lambert/AJ/README.md

# AJ SX28AC/DP board with an Arduino UNO R3 form factor

[Documentation](docs/README.md).

[Electrical CAD files](ecad/README.md)

[Mechanical CAD files](mcad/README.md)

CC BY-SA
