lambert/AJ/ecad/gschem/README.md

# Schematic entry

## Schematics

[Front page](AJ.000.00.00.01.sch)

[Arduino Parallax/Scenix SX28AC Board - schematic](AJ.001.00.01.01.sch)

[Oscillator Daughter Board - schematic](AJ.002.00.01.01.sch)

Schematic entry requires [gschem version 1.6.2-20110115](http://wiki.geda-project.org/geda:download) or later.

## Engineering Change Orders

[ECO-001](ECO-001.md)

[ECO-002](ECO-002.md)

## Generated files

[Bill Of Materials](BOM/README.md)

[Design Rule Checking reports](DRC/README.ms)

[Netlist Checking reports](geda-netlist/README.md)
