lambert/AJ/ecad/pcb/plotfiles/README.md

# Plot files (PDF)

[AJ.001.00.01.01](AJ.001.00.01.01.pcb.pdf)
