lambert/AJ/ecad/pcb/eyecandy/README.md

# Eye candy

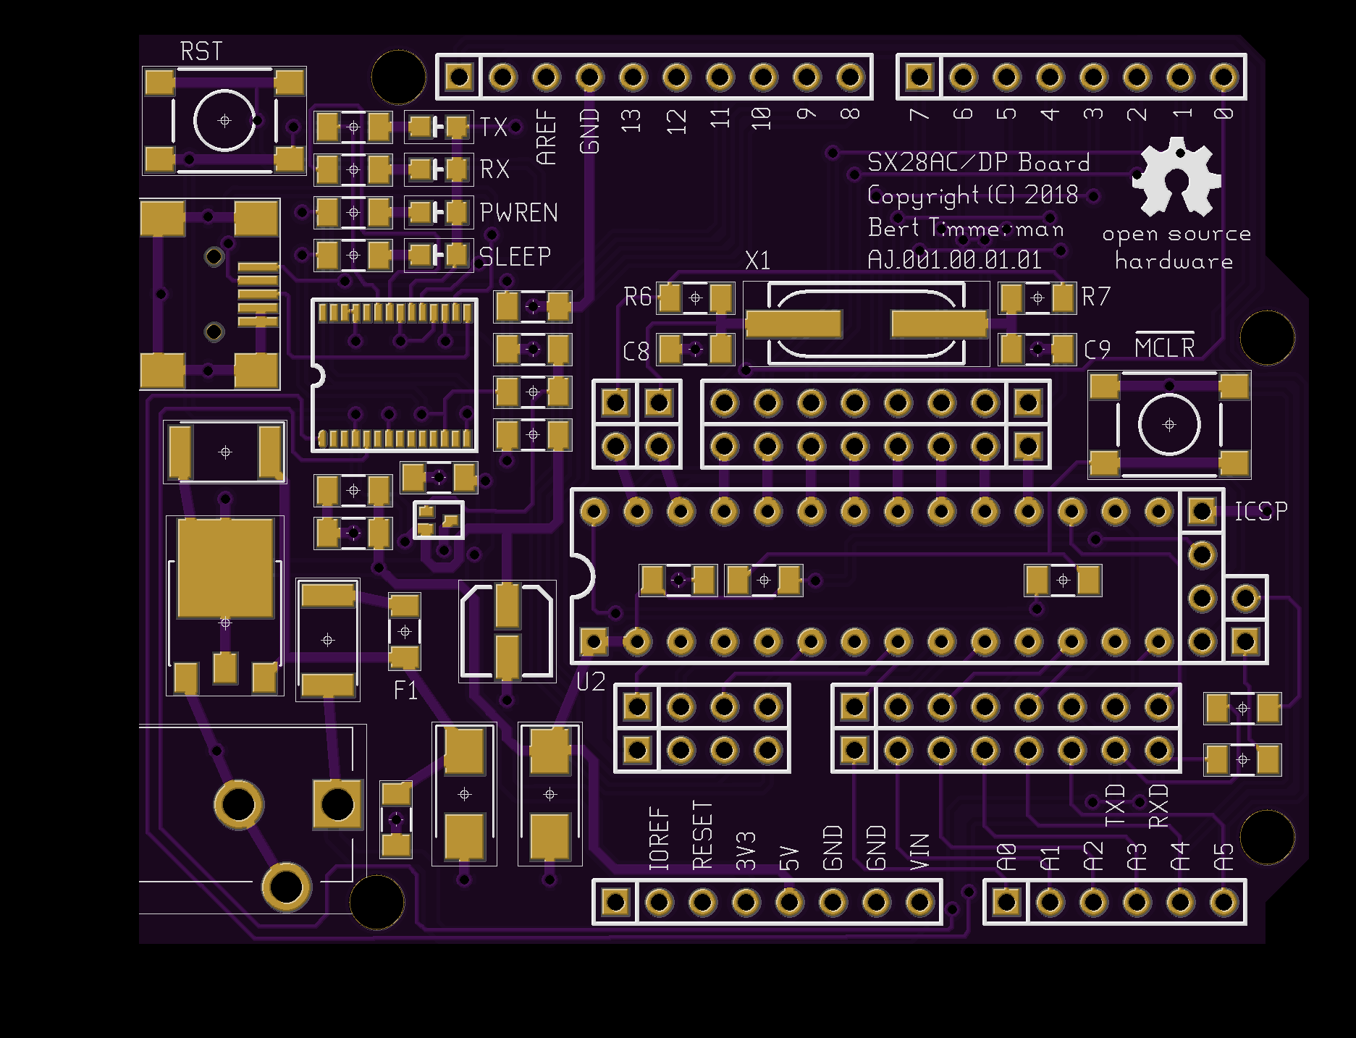
[picture p2: ecad/pcb/eyecandy/AJ.001.00.01.01.pcb.top.png]
Top view


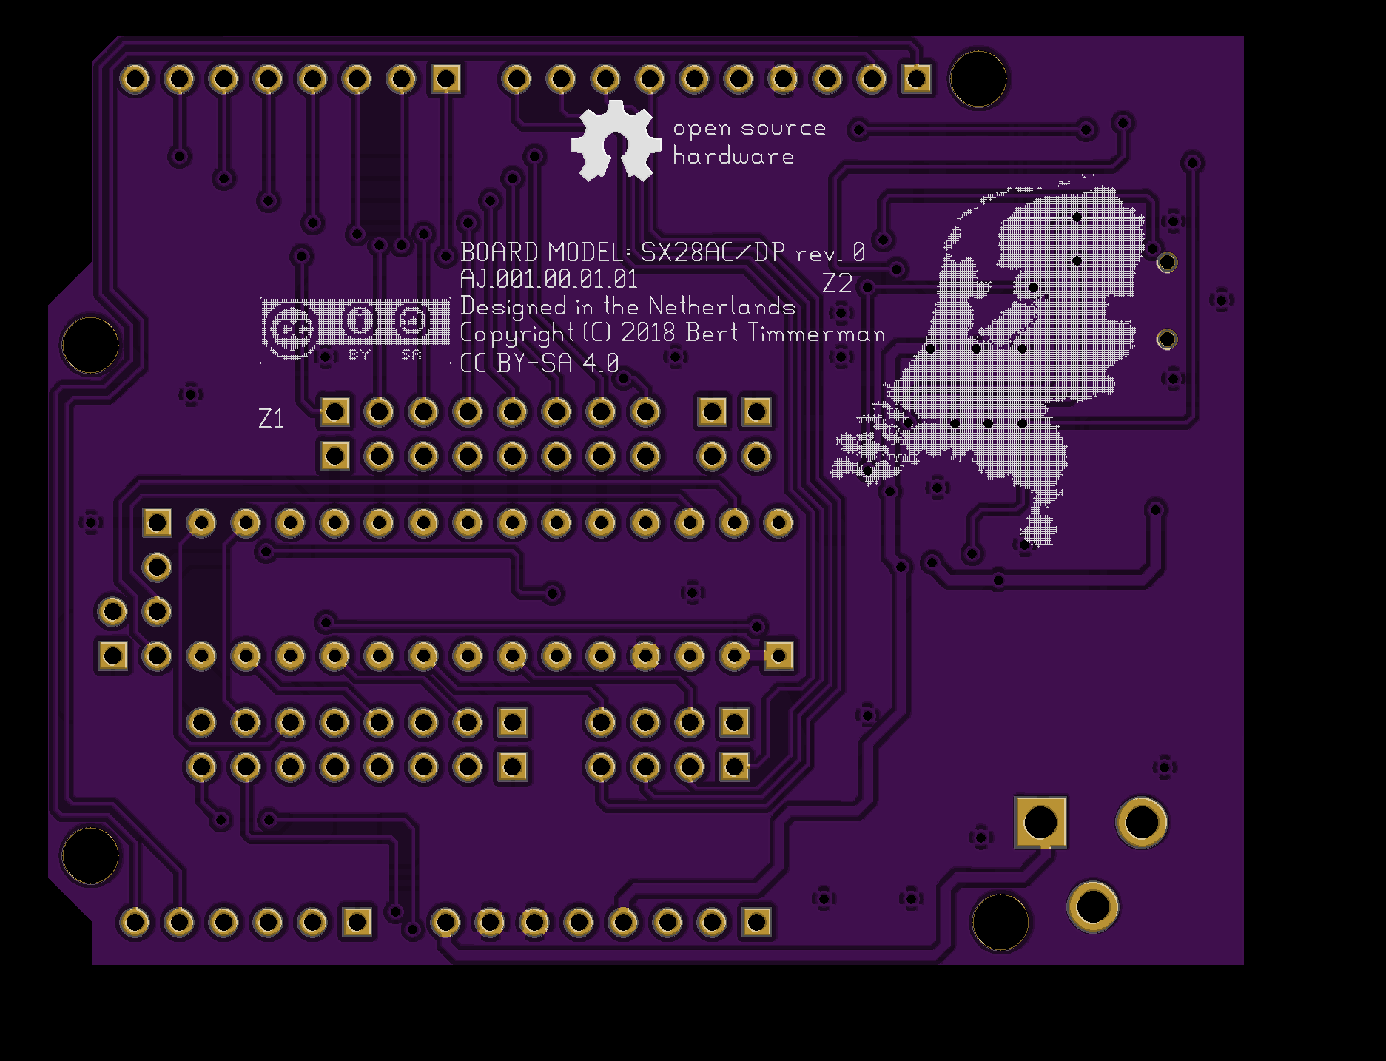
[picture p3: ecad/pcb/eyecandy/AJ.001.00.01.01.pcb.bottom.png]
Bottom view
