lambert/AJ/ecad/gschem/ECO-002.md

# Engineering Change Order 002

## Description:

New revisons need a power indicator LED for both USB (USB_5V) and jack power (5V).

A power indicator for 3V3 and/or Vcc if enough board space available.

## Remedial actions:

Add to schematic and BOM.

Redesign layout (revision 01).

Purchase additional parts.
