lambert/AJ/docs/purchase/SeeedStudio/README.md

# SeeedSudio Fusion PCB

[Fusion PCB specification](fusion_pcb_specification.md)

[PCB Order information](pcb_order_information.md)
