lambert/AJ/ecad/gschem/BOM/README.md

# Bill Of Materials

[Bill Of Materials](AJ_ARDUINO_SX28AC_Board_bom.csv)
