lambert/AJ/ecad/pcb/bom/README.md

# Bill Of Materials

[AJ.001.00.01.01 Main Board](AJ.001.00.01.01.pcb.bom)
