lambert/AJ/docs/purchase/SeeedStudio/pcb_order_information.md

# PCB Order information

Order Number : 180915202001

2018-09-15 14:15:01

Total : USD 12.50

Ship To : Bert Timmerman

Status : Confirmed

Fusion PCB

SKU: 501010001

USD 1.00 × 1

PCB Dimension - 100 mm * 100 mm

Impedance Control - No

Surface Finish - HASL

Min Solder Mask Dam - 0.4 mm

Copper Weight - 1 oz.

Half-cut / Castellated Holes - No

Min Hole Size - 0.3 mm

PCB Color - Green

Material - FR4 TG130

Layer - 2

PCB Qty. - 3

Blind Vias - No

PCB Thickness - 1.6 mm

Min Tracking / Spacing - 6/6 mil

Panelized PCBs - 1

Expedited Option - No

File - D_928359_aj00100.zip

# Received PCBs

[Photo 1](20181011_01.jpg)

[Photo 2](20181011_02.jpg)

[Photo 3](20181011_03.jpg)

[Photo 4](20181011_04.jpg)

[Photo 5](20181011_05.jpg)
