lambert/AJ/docs/purchase/OSH_Park/AJ-001-00/pics/AJ-001-00_bottom_silk_screen.png

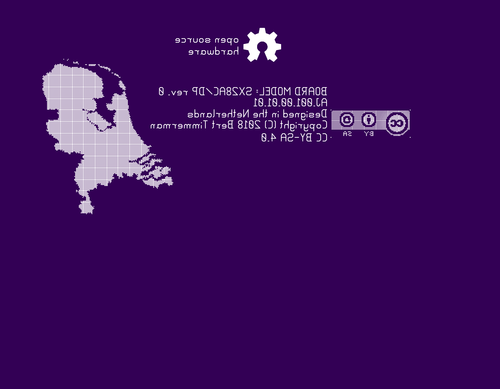
docs/purchase/OSH_Park/AJ-001-00/pics/AJ-001-00_bottom_silk_screen.png
