lambert/AJ/docs/purchase/SeeedStudio/20181011_01.jpg

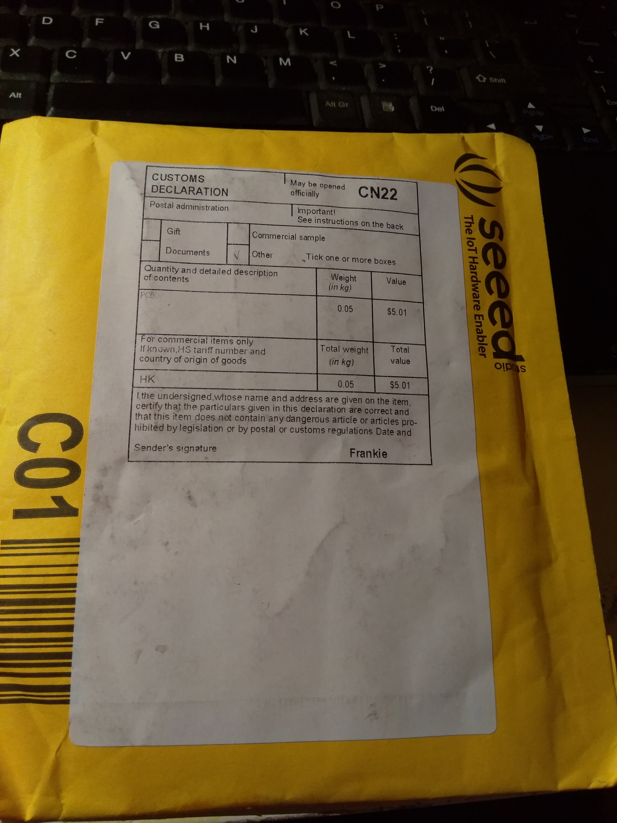
docs/purchase/SeeedStudio/20181011_01.jpg
