lambert/AJ/docs/purchase/SeeedStudio/20181011_02.jpg

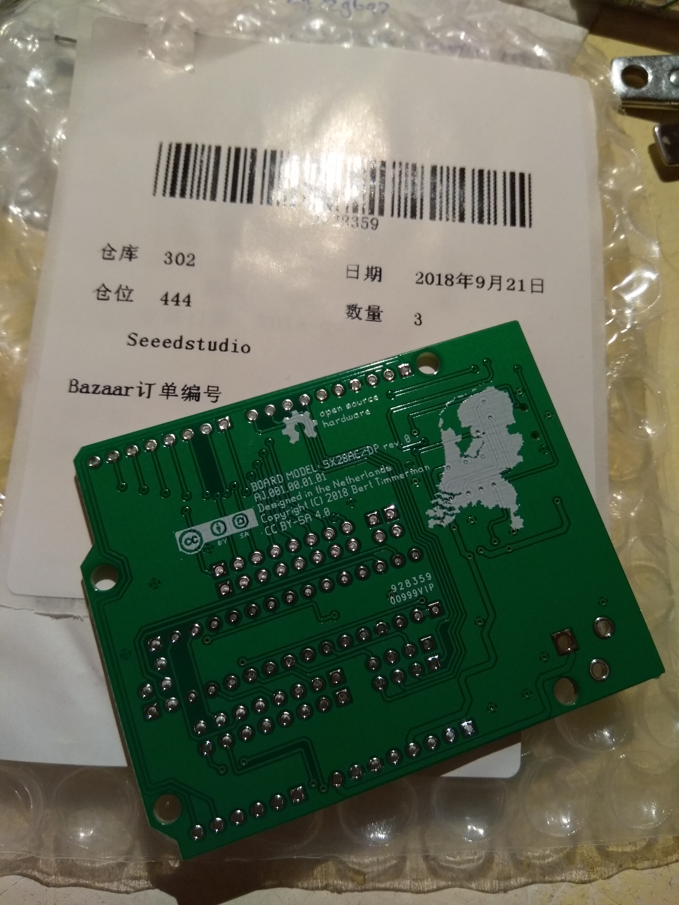
docs/purchase/SeeedStudio/20181011_02.jpg
