lambert/AJ/docs/purchase/SeeedStudio/20181011_03.jpg

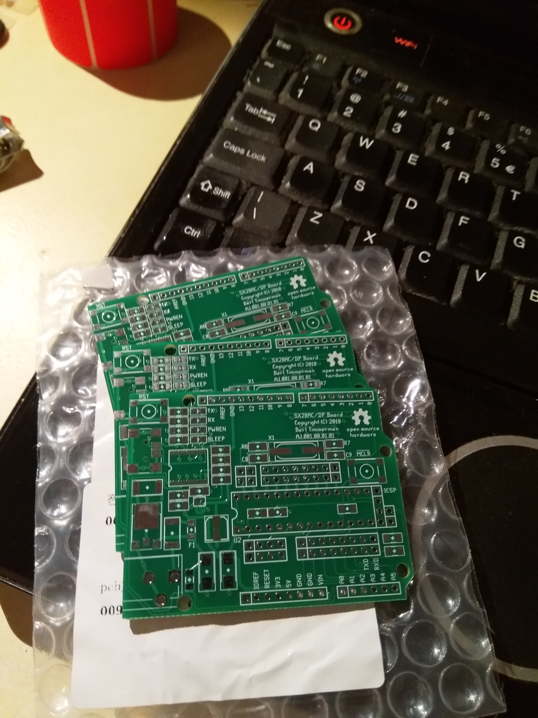
docs/purchase/SeeedStudio/20181011_03.jpg
