lambert/AJ/docs/purchase/SeeedStudio/20181011_04.jpg

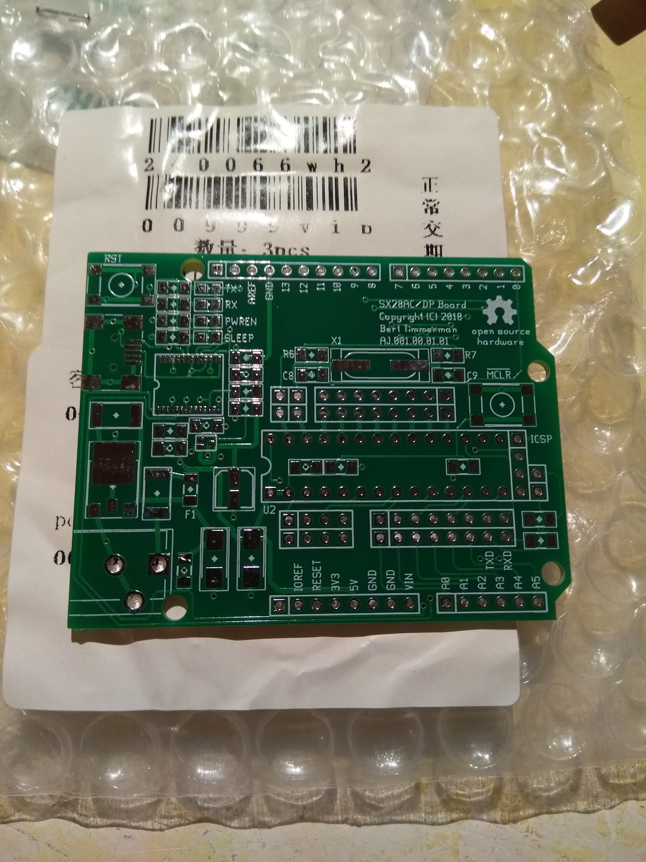
docs/purchase/SeeedStudio/20181011_04.jpg
