lambert/AJ/docs/purchase/SeeedStudio/20181011_05.jpg

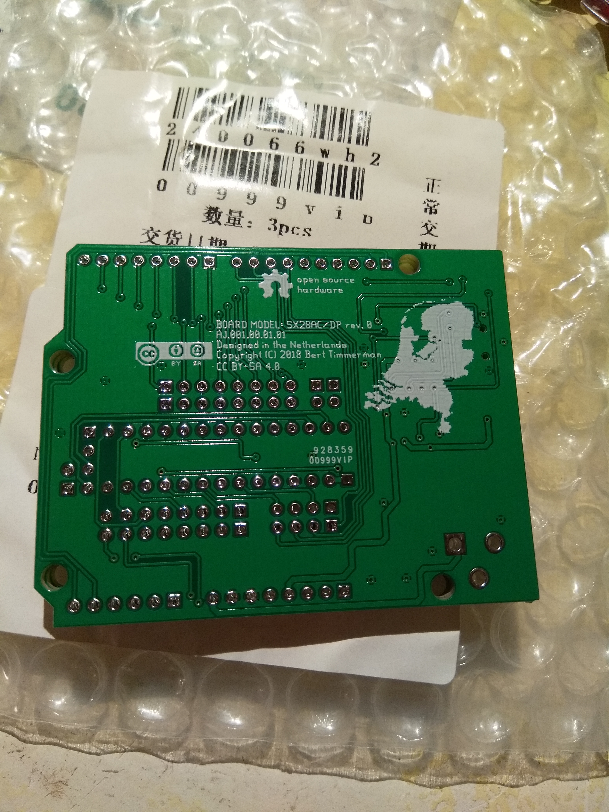
docs/purchase/SeeedStudio/20181011_05.jpg
