lambert/AJ/(list of files, cad)

Other CAD files:
mcad/parts/AJ_assembly.dwg
mcad/parts/AJ.001.00.01.01.dwg
