lambert/AJ/ecad/pcb/test/README.md

# IPC-D-356 Test files

[AJ.001.00.01.01](AJ.001.00.01.01.pcb.ipc-d-356)
