lambert/AJ/(threads)

Thread 1 (2018-12-16):

ECO-001

lambert, 2018-12-16:
# Description:

Layout was done with 1206 footprints for C8 and C9, while the schematic attributes and generated BOM contains 0805 parts for C8 and C9.

# Remedial actions:

Schematic and generated BOM need to be updated.

Order 1206 size parts.

lambert, 2018-12-16:
Resolved in 55086bb4869c7846480890e26c0b901ab36e81fa

Closed 2018-12-16.

Thread 2 (2018-12-16):

ECO-002

lambert, 2018-12-16:
# Description:

New revisons need a power indicator LED for both USB  (USB_5V) and jack power (5V).

A power indicator for 3V3 and/or Vcc if enough board space available.

# Remedial actions:

Add to schematic and BOM.

Redesign layout (revision 01).

Purchase additional parts.
