lambert/AJ/docs/AJ_ARDUINO_SX28AC_Board-schematics.pdf

| Arduino - Parallax/Scenix SX28AC Board Front Page ARDUINO_SX28AC TITLE
FILE: AJ.000.00.00.01.sch 01 01 PAGE OF | REVISION: 20181117 Bert Timmerman DRAWN BY: | A3

This hardware is released under Creative Commons Share-alike 4.0 International (http://creativecommons.org/licenses/by-sa/4.0/).

Note: This is a human-readable summary of (and not a substitute for) the license (http://creativecommons.org/licenses/by-sa/4.0/legalcode).

You are free to:

Share — copy and redistribute the material in any medium or format

Adapt — remix, transform, and build upon the material
for any purpose, even commercially.

The licensor cannot revoke these freedoms as long as you follow the license terms.

Under the following terms:

Attribution — You must give appropriate credit, provide a link to the license, and indicate if changes were made. You may do so in any reasonable manner, but not in any way that suggests the licensor endorses you or your use.

ShareAlike — If you remix, transform, or build upon the material, you must distribute your contributions under the same license as the original.

No additional restrictions — You may not apply legal terms or technological measures that legally restrict others from doing anything the license permits.

Notices:

You do not have to comply with the license for elements of the material in the public domain or where your use is permitted by an applicable exception or limitation.

No warranties are given. The license may not give you all of the permissions necessary for your intended use. For example, other rights such as publicity, privacy, or moral rights may limit how you use the material.

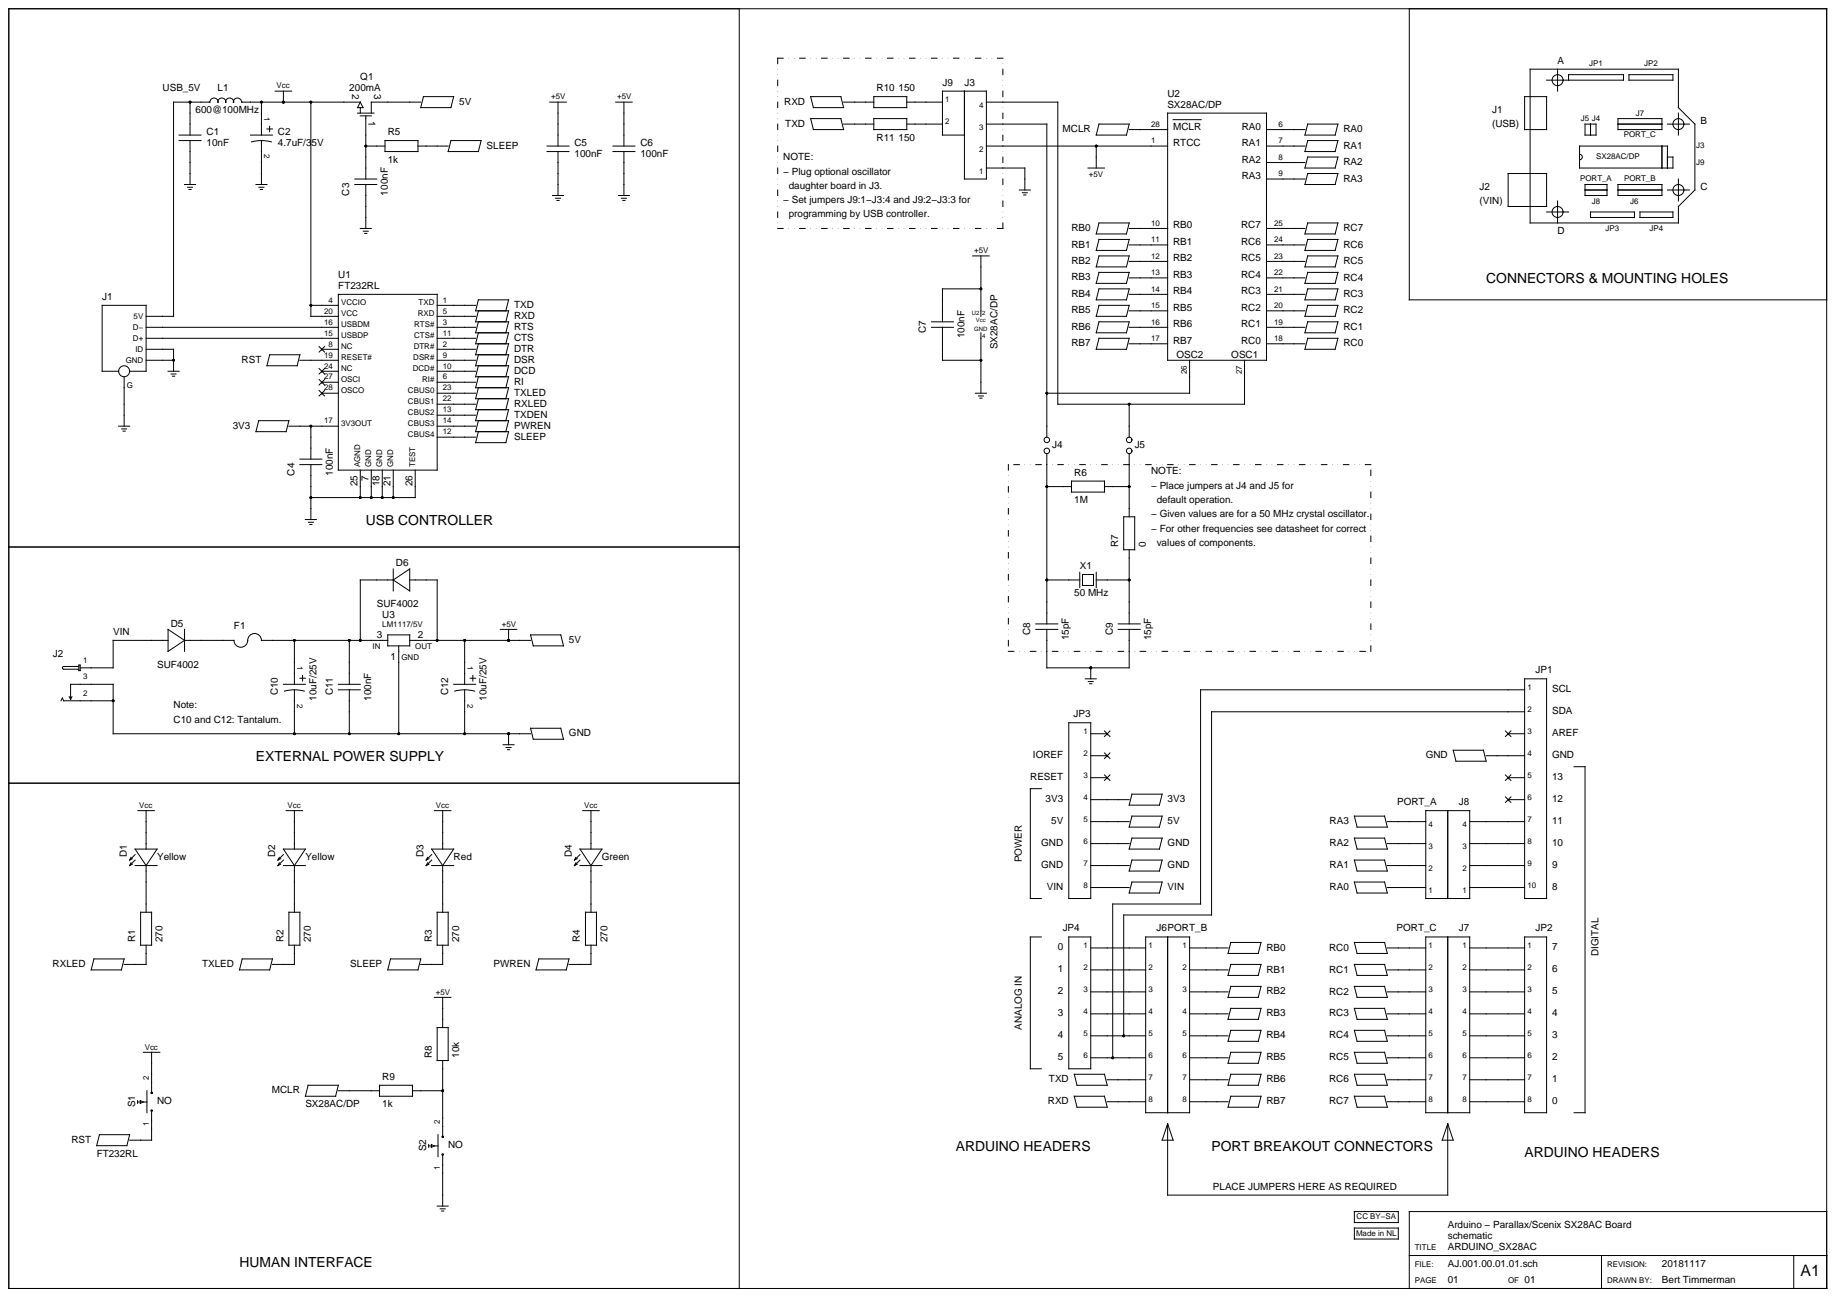
[picture p21: page 2]

NOTE:
− Plug optional oscillator
daughter board in J3.
− Set jumpers J9:1−J3:4 and J9:2−J3:3 for
programming by USB controller.

− Place jumpers at J4 and J5 for
default operation.
− Given values are for a 50 MHz crystal oscillator.
− For other frequencies see datasheet for correct
values of components.

PLACE JUMPERS HERE AS REQUIRED

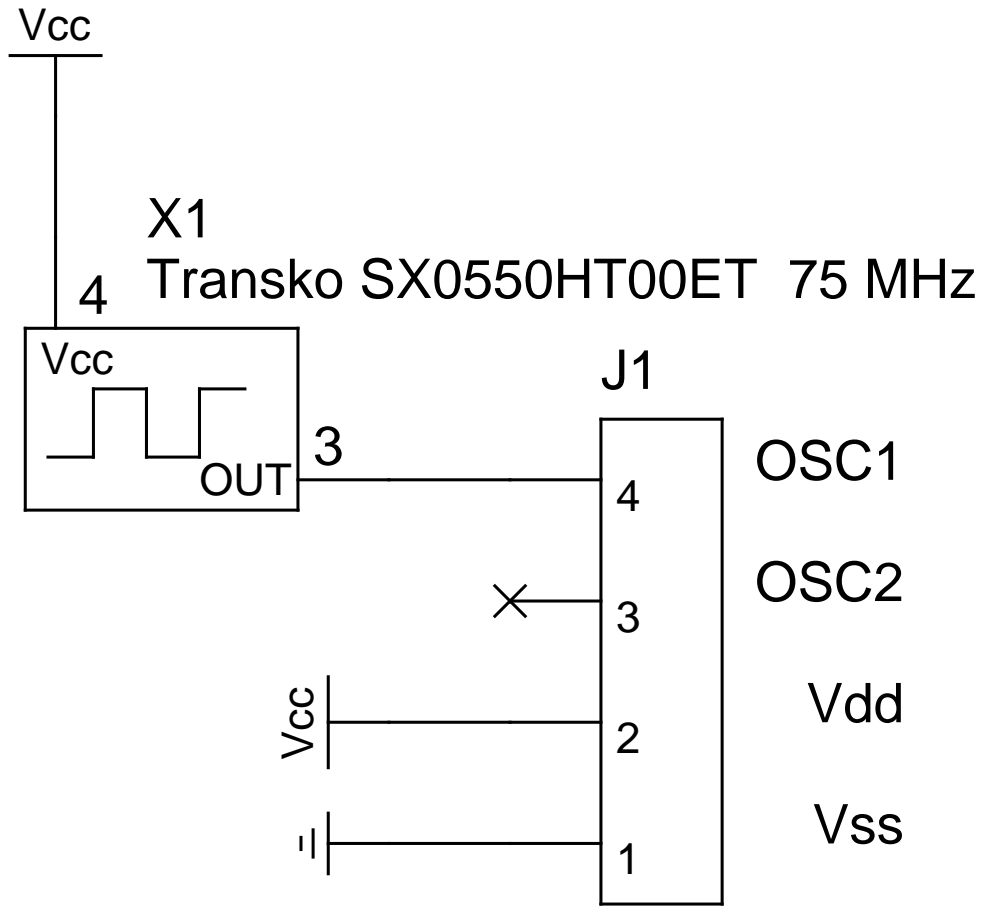
[picture p22: page 3]
Oscillator Daughter Board; 3 OUT; Transko SX0550HT00ET 75 MHz
