lambert/AJ/ecad/pcb/plotfiles/AJ.001.00.01.01.pcb.pdf

## AJ.001.00.01.01.pcb

## 1. Table of Contents (This Page) Created on Wed Nov 6 20:00:44 2019 2. top 3. bottom 4. outline 5. plated-drill 6. unplated-drill 7. componentmask 8. soldermask 9. topsilk 10. bottomsilk 11. toppaste 12. topassembly 13. bottomassembly 14. fab

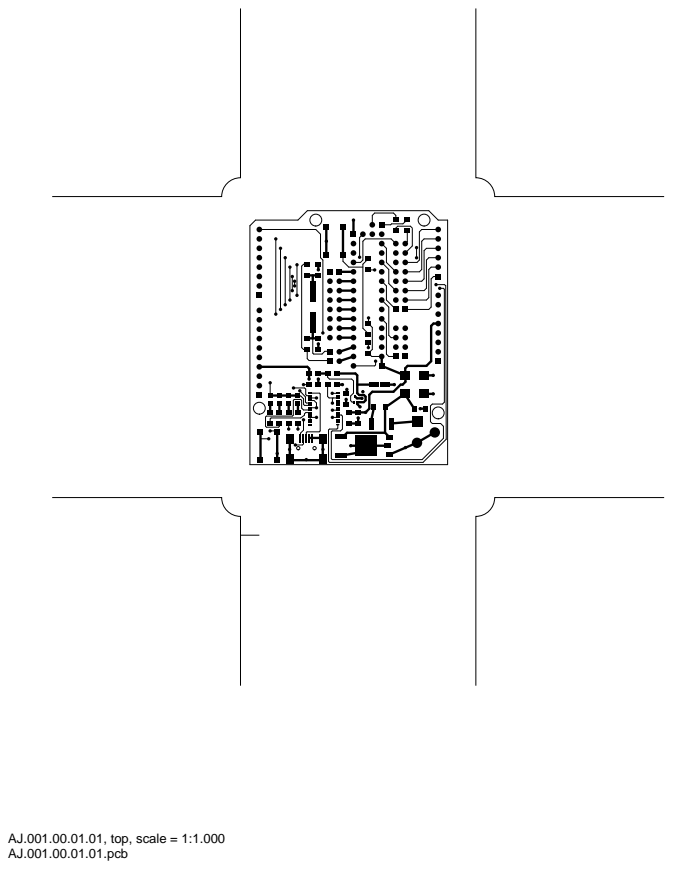
[picture p23: page 2]

AJ.001.00.01.01, top, scale = 1:1.000

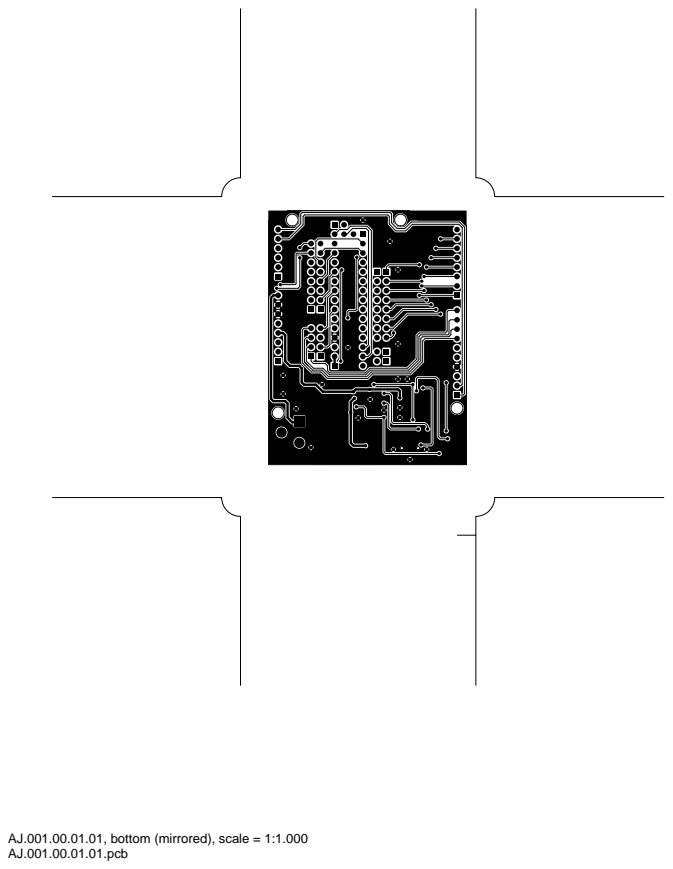
[picture p24: page 3]

AJ.001.00.01.01, bottom (mirrored), scale = 1:1.000

AJ.001.00.01.01, outline, scale = 1:1.000

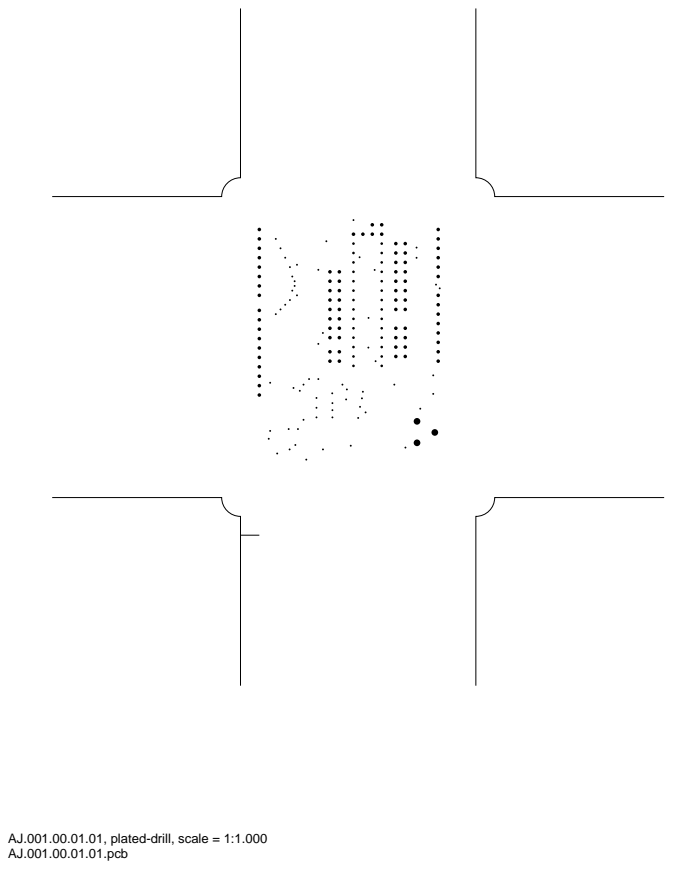
[picture p25: page 5]

AJ.001.00.01.01, plated-drill, scale = 1:1.000

AJ.001.00.01.01, unplated-drill, scale = 1:1.000

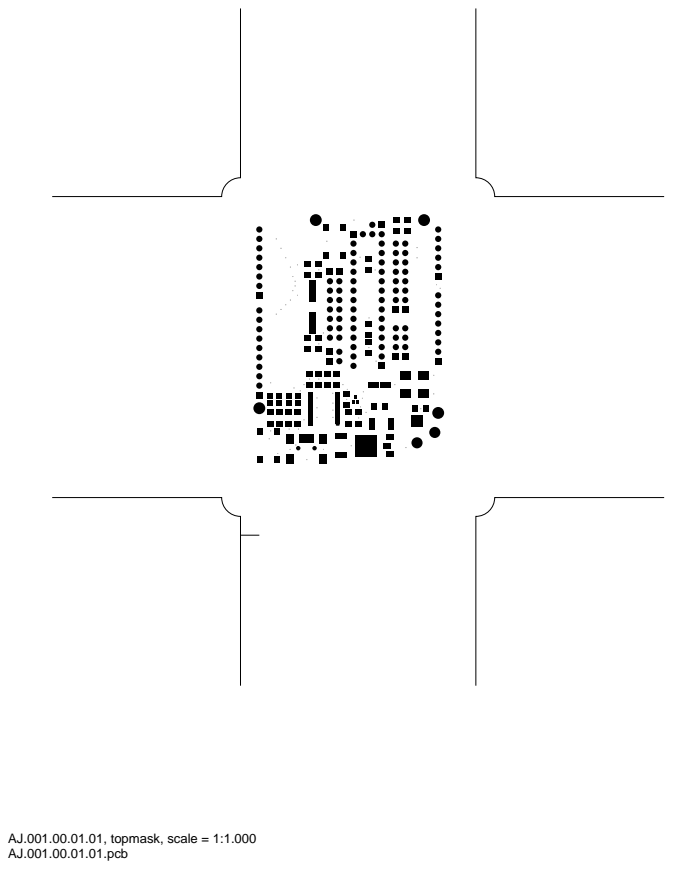
[picture p26: page 7]

AJ.001.00.01.01, topmask, scale = 1:1.000

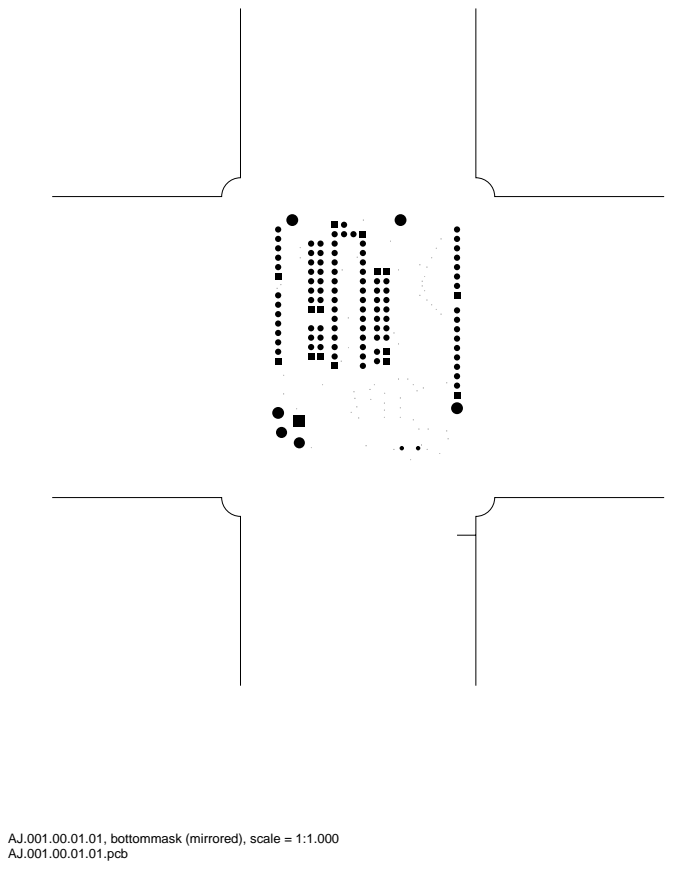
[picture p27: page 8]

AJ.001.00.01.01, bottommask (mirrored), scale = 1:1.000

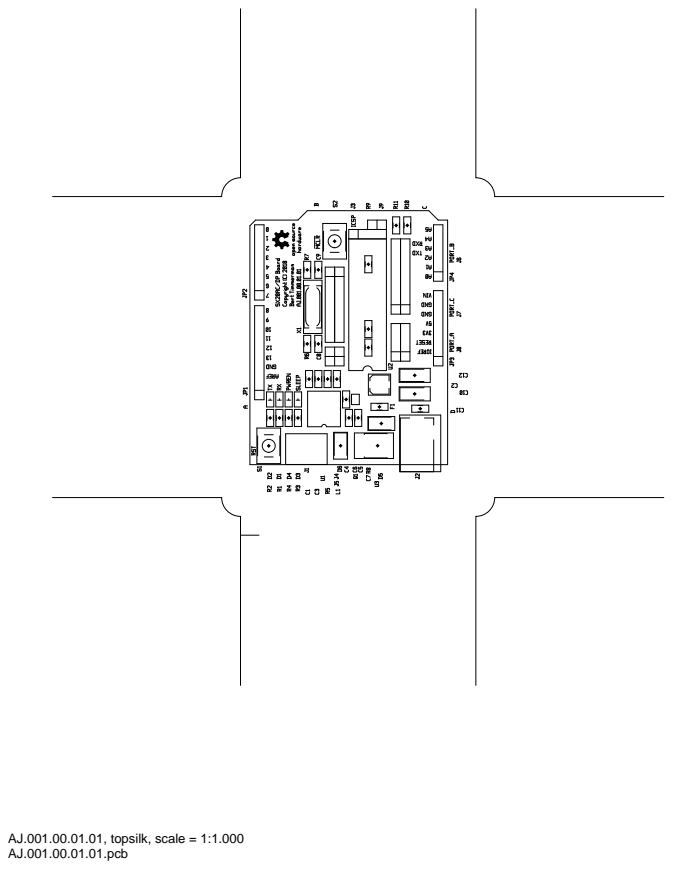
[picture p28: page 9]

AJ.001.00.01.01, topsilk, scale = 1:1.000

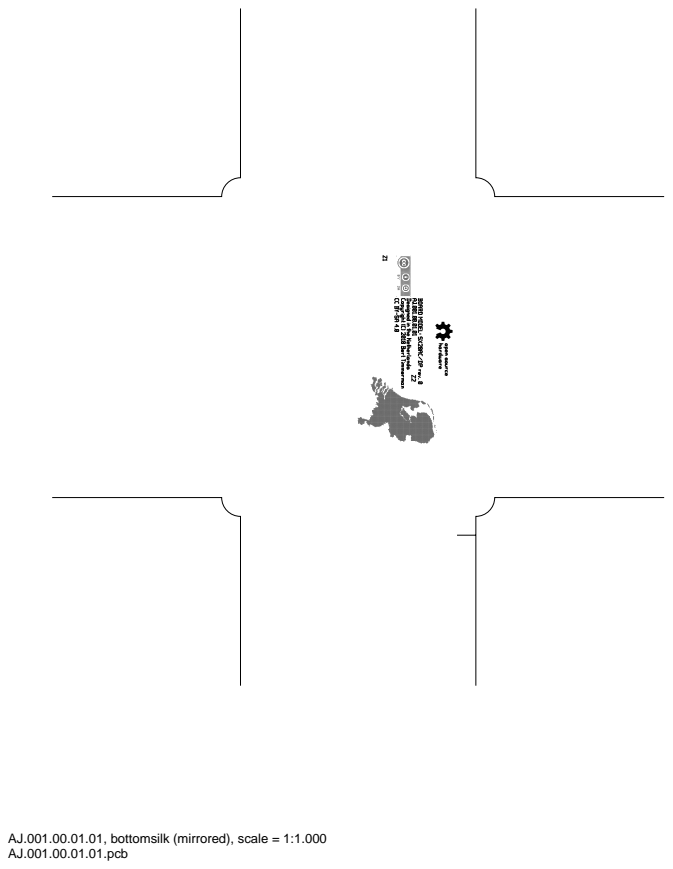
[picture p29: page 10]

AJ.001.00.01.01, bottomsilk (mirrored), scale = 1:1.000

AJ.001.00.01.01, toppaste, scale = 1:1.000

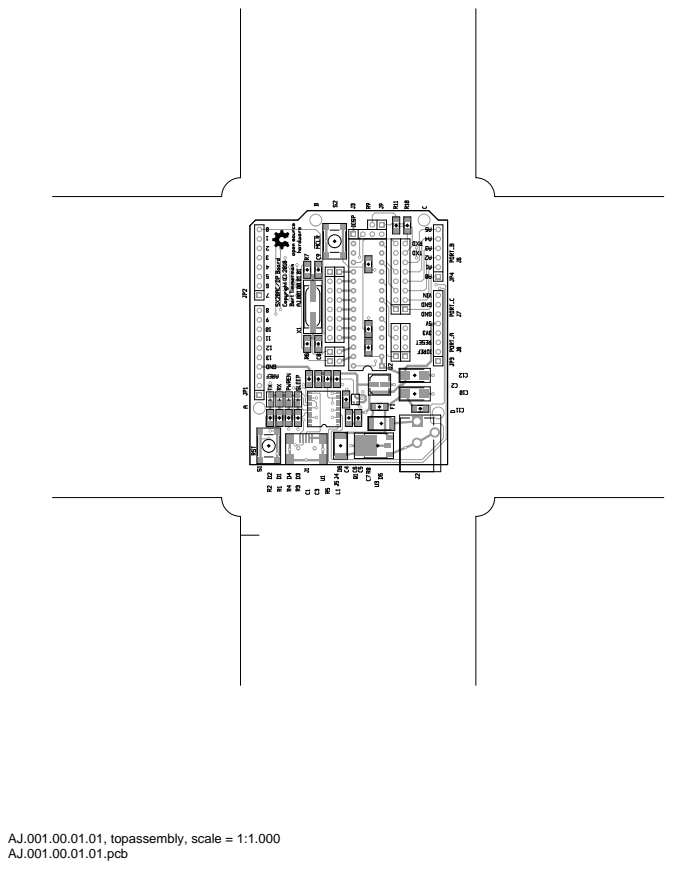
[picture p30: page 12]

AJ.001.00.01.01, topassembly, scale = 1:1.000

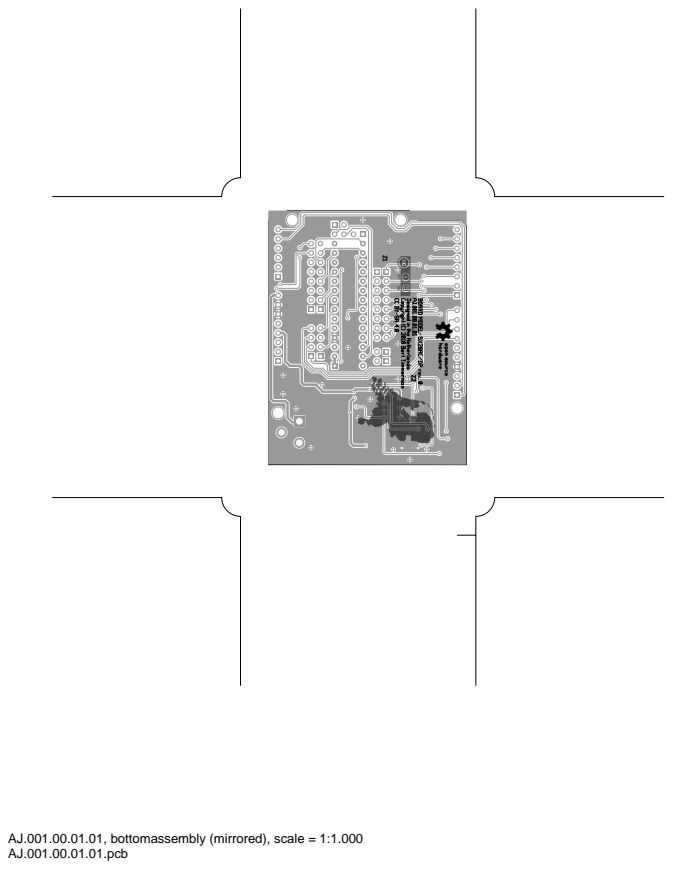
[picture p31: page 13]

AJ.001.00.01.01, bottomassembly (mirrored), scale = 1:1.000

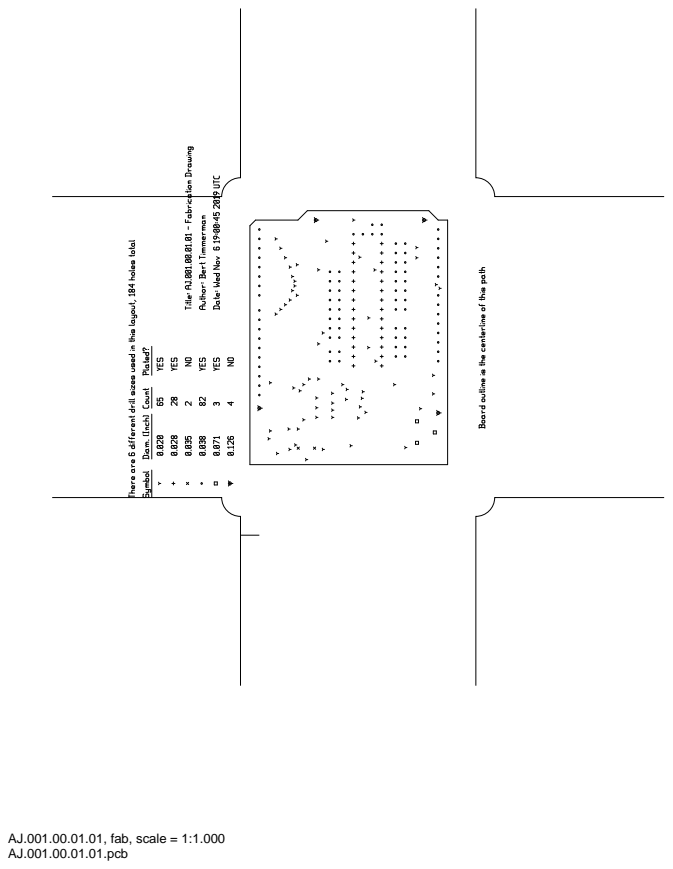
[picture p32: page 14]

AJ.001.00.01.01, fab, scale = 1:1.000
