lambert/AJ/(list of files, drawings)

Other design files:
ecad/pcb/AJ.001.00.01.01.pcb
ecad/pcb/AJ.002.00.01.01.pcb
