lambert/AJ/(commit log)

2018-07-02 Added a Makefile for pcb.
2018-07-02 Added a README for pcb.
2018-07-02 Added a front page for schematics.
    [AJ.000.00.00.01.sch]
2018-09-07 Updated the pcb Makefile.
2018-09-07 Added schematic files.
    [AJ.001.00.01.01.sch, AJ.002.00.01.01.sch, AJ_ARDUINO_SX28AC_Board_bom.csv]
2018-09-07 Added pcb files.
    [AJ.001.00.01.01.GBL, AJ.001.00.01.01.GBO, AJ.001.00.01.01.GBS, AJ.001.00.01.01.GKO, AJ.001.00.01.01.GTL, AJ.001.00.01.01.GTO, AJ.001.00.01.01.GTS, AJ.001.00.01.01.XLN]
2018-09-10 Updated schematic.
    [AJ.001.00.01.01.sch]
2018-09-10 Updated pcb.
    [AJ.001.00.01.01.GBL, AJ.001.00.01.01.GBS, AJ.001.00.01.01.GKO, AJ.001.00.01.01.GTL, AJ.001.00.01.01.GTO, AJ.001.00.01.01.GTS, AJ.001.00.01.01.XLN, AJ.001.00.01.01.gtp]
2018-09-10 Added a gerber project definition file.
2018-09-14 Updated the pcb.
    [AJ.001.00.01.01.GBL, AJ.001.00.01.01.GBO, AJ.001.00.01.01.GBS, AJ.001.00.01.01.GKO, AJ.001.00.01.01.GTL, AJ.001.00.01.01.GTO, AJ.001.00.01.01.GTS, AJ.001.00.01.01.XLN]
2018-09-16 Updated schematic.
    Removed most embedded components.
    [AJ.001.00.01.01.sch]
2018-09-16 Updated pcb layout.
    [AJ.001.00.01.01.GBL, AJ.001.00.01.01.GBO, AJ.001.00.01.01.GBS, AJ.001.00.01.01.GKO, AJ.001.00.01.01.GTL, AJ.001.00.01.01.GTO, AJ.001.00.01.01.GTS, AJ.001.00.01.01.gtp]
2018-09-17 Added compressed gerbers and pictures of layout.
2018-10-24 Updated the schematic.
    ECO-001 + various other part attributes.
    [AJ.001.00.01.01.sch]
2018-10-24 Added schematics in docs (pdf).
2018-10-24 Updated the BOM from schemtics.
    [AJ_ARDUINO_SX28AC_Board_bom.csv]
2018-11-17 Updated the OSH Park BOM.
2018-11-17 Updated schematic front page.
    [AJ.000.00.00.01.sch]
2018-11-17 Updated schematic and pcb files.
    [AJ.001.00.01.01.GBL, AJ.001.00.01.01.GBO, AJ.001.00.01.01.GBS, AJ.001.00.01.01.GKO, AJ.001.00.01.01.GTL, AJ.001.00.01.01.GTO, AJ.001.00.01.01.GTS, AJ.001.00.01.01.gtp]
2018-11-17 Updated the schematics pdf.
2019-04-07 Added a README file for pcb fabrication files.
2019-04-07 Removed symbols with zero length pin.
    [AJ.001.00.01.01.sch]
2019-04-07 Embed components.
    [AJ.001.00.01.01.sch]
2021-01-02 Added mcad files.
    [AJ.001.00.01.01.dwg, AJ_assembly.dwg]
